tmilkovic51/stm32_usb_device/README.md

# STM32 USB device
A simple PCB consisting of an STM32F103C8T6 microcontroller acting as a USB device and 3 UART pin headers connected to MCU's UART pins.

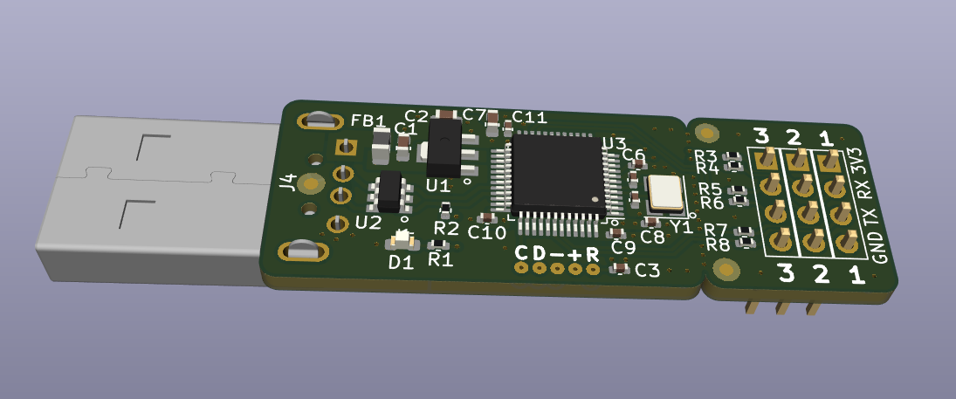
[picture p1: doc/img/stm32f1_usb_device_pcb.png]
STM32F1 USB device
