tmilkovic51/stm32_usb_device/stm32_usb_device.kicad_pcb

## KiCad design stm32_usb_device.kicad_pcb (2024-09-15)

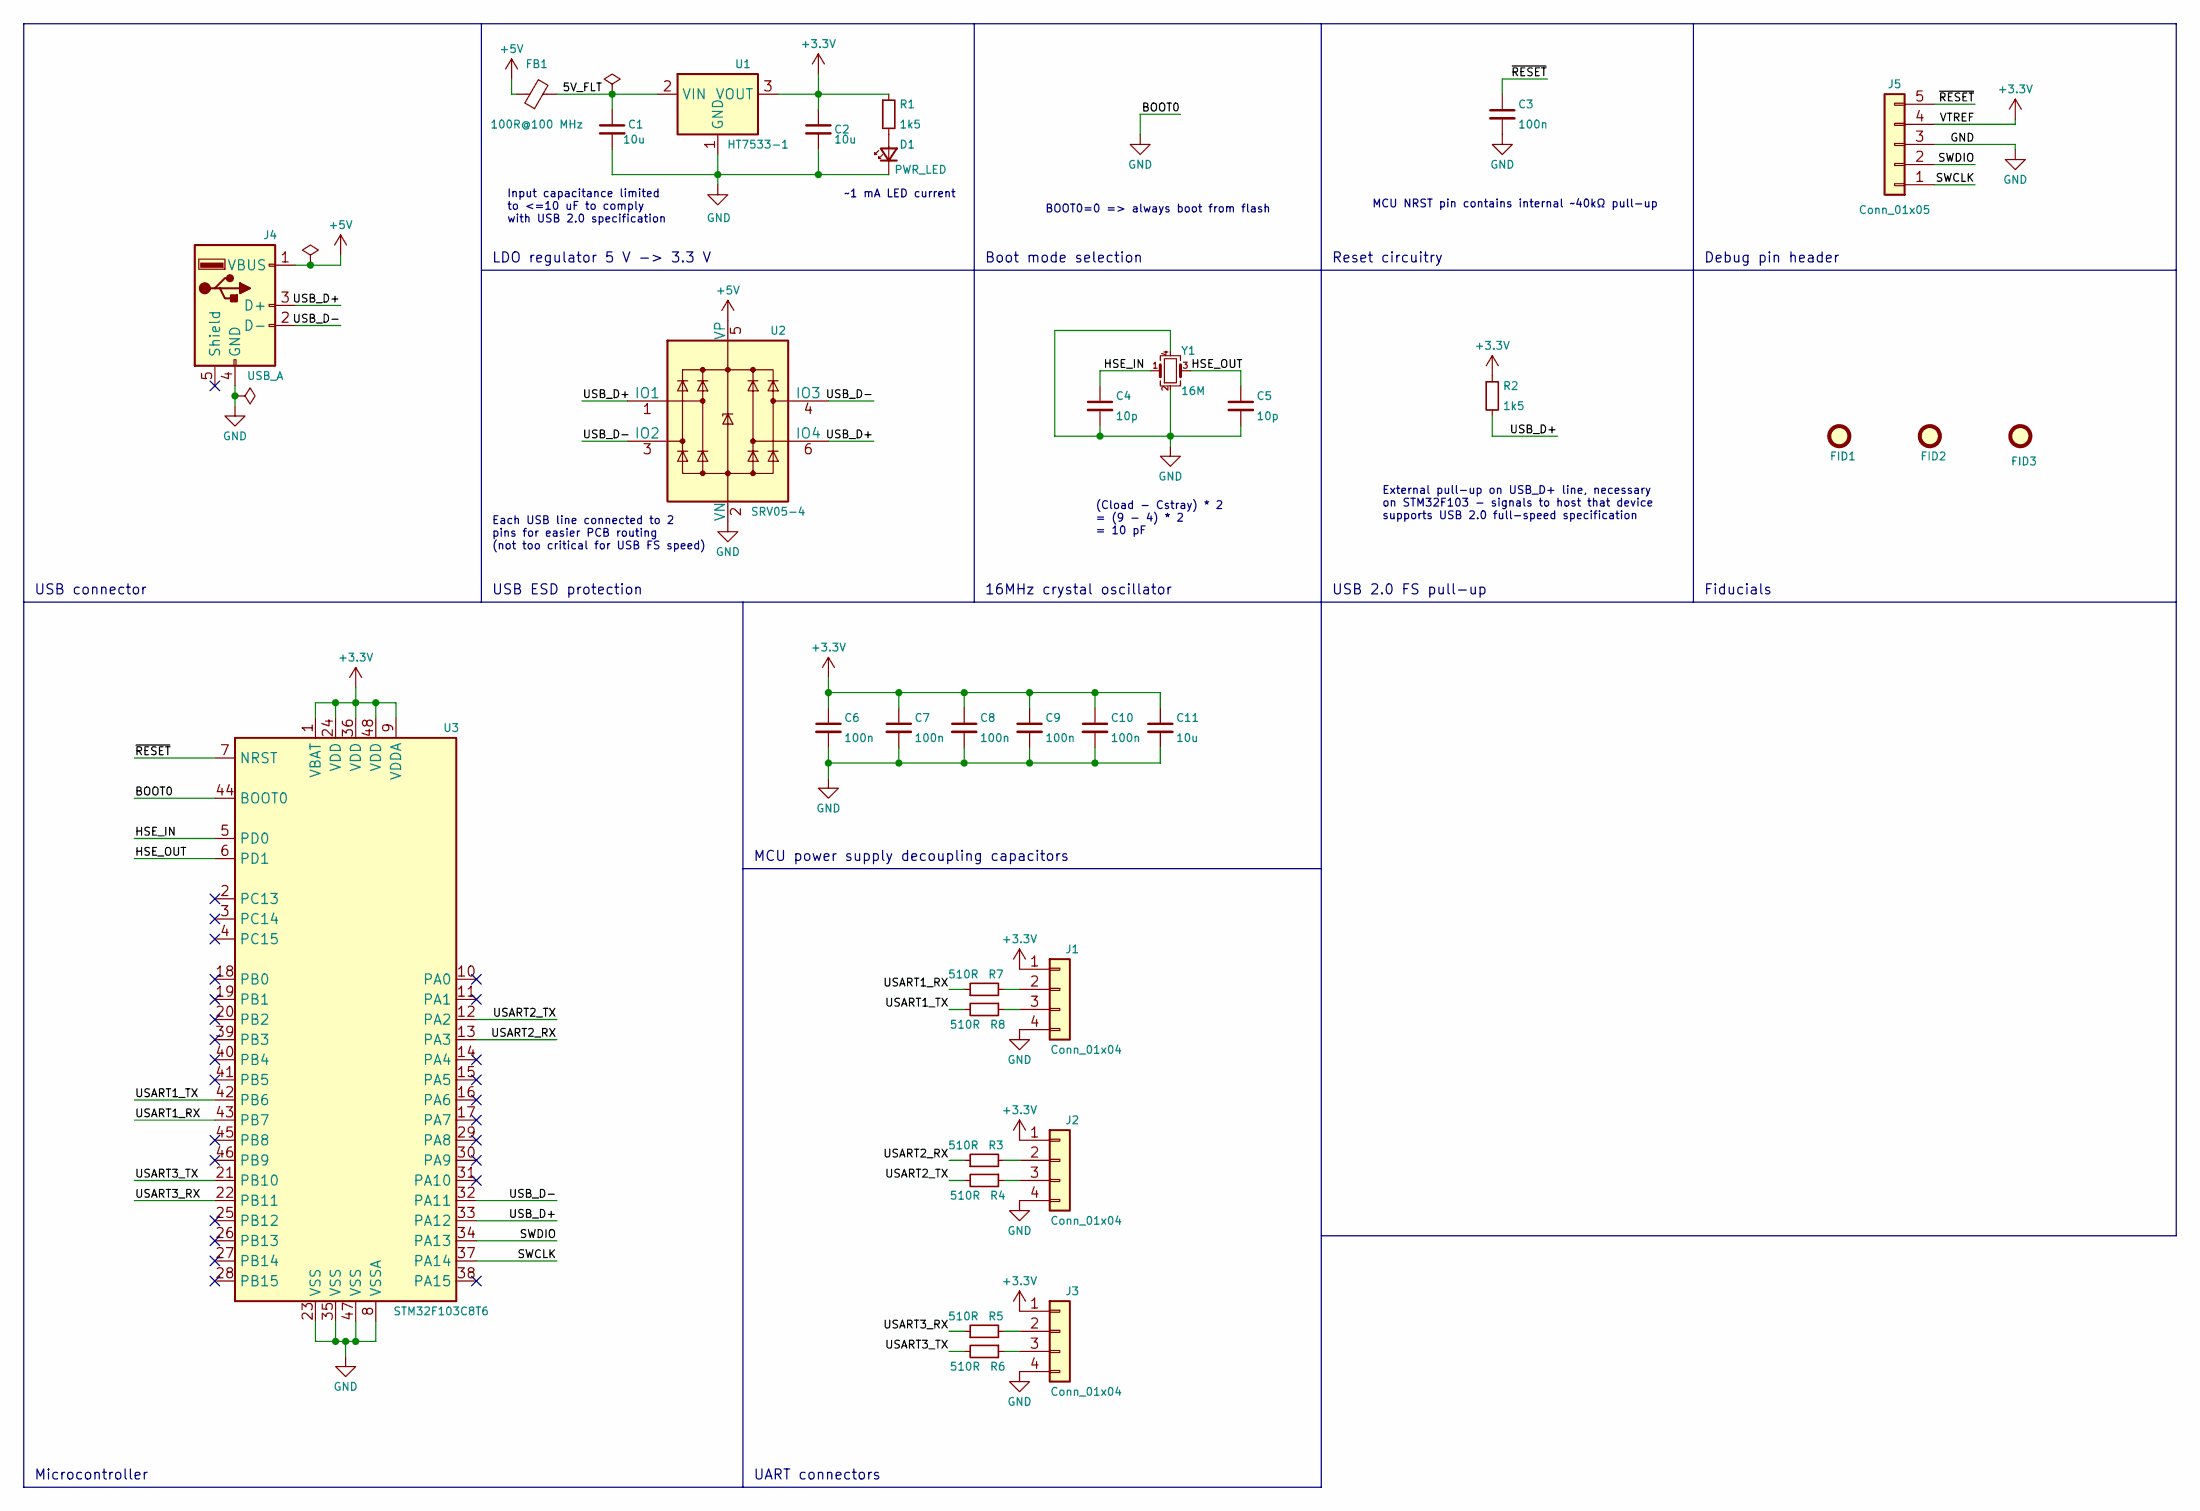
[picture p2: schematic stm32_usb_device.kicad_sch, STM32 USB to triple UART adapter]

Parts:
C1, C2, C11: 10u; C_0603_1608Metric; LCSC C96446
C3, C6, C7, C8, C9, C10: 100n; C_0402_1005Metric; LCSC C307331
C4, C5: 10p; C_0402_1005Metric; LCSC C32949
D1: PWR_LED; LED_0603_1608Metric; LCSC C2286
FB1: 100R@100 MHz; L_0805_2012Metric
FID1, FID2, FID3: Fiducial; Fiducial_1mm_Mask2mm
J1, J2, J3: Conn_01x04; PinHeader_1x04_P2.54mm_Vertical
J4: USB_A; USB_A_4pin
J5: Conn_01x05; PinHeader_1x05_P1.27mm_Vertical_SMD_Pin1Left
R1, R2: 1k5; R_0402_1005Metric; LCSC C25867
R3, R4, R5, R6, R7, R8: 510R; R_0402_1005Metric; LCSC C25123
U1: HT7533-1; SOT-89-3; LCSC C14289
U2: SRV05-4; SOT-23-6; LCSC C7420376
U3: STM32F103C8T6; LQFP-48_7x7mm_P0.5mm; LCSC C8734
Y1: 16M; Crystal_SMD_3225-4Pin_3.2x2.5mm; LCSC C13738

Connections:
+3.3V: C2.1, C6.1, C7.1, C8.1, C9.1, C10.1, C11.1, J1.1, J2.1, J3.1, J5.4, R1.1, R2.1, U1.3 (VOUT), U3.1 (VBAT), U3.9 (VDDA), U3.24 (VDD), U3.36 (VDD), U3.48 (VDD)
+5V: FB1.1, J4.1 (VBUS), U2.5 (VP)
/5V_FLT: C1.1, FB1.2, U1.2 (VIN)
/HSE_IN: C4.1, U3.5 (PD0), Y1.1
/HSE_OUT: C5.1, U3.6 (PD1), Y1.3
/SWCLK: J5.1, U3.37 (PA14)
/SWDIO: J5.2, U3.34 (PA13)
/USART1_RX: R7.1, U3.43 (PB7)
/USART1_TX: R8.2, U3.42 (PB6)
/USART2_RX: R3.1, U3.13 (PA3)
/USART2_TX: R4.2, U3.12 (PA2)
/USART3_RX: R5.1, U3.22 (PB11)
/USART3_TX: R6.2, U3.21 (PB10)
/USB_D+: J4.3 (D+), R2.2, U2.1 (IO1), U2.6 (IO4), U3.33 (PA12)
/USB_D-: J4.2 (D-), U2.3 (IO2), U2.4 (IO3), U3.32 (PA11)
/~RESET: C3.1, J5.5, U3.7 (NRST)
GND: C1.2, C2.2, C3.2, C4.2, C5.2, C6.2, C7.2, C8.2, C9.2, C10.2, C11.2, D1.1 (K), J1.4, J2.4, J3.4, J4.4 (GND), J5.3, U1.1 (GND), U2.2 (VN), U3.8 (VSSA), U3.23 (VSS), U3.35 (VSS), U3.44 (BOOT0), U3.47 (VSS), Y1.2, Y1.4
unnamed: D1.2 (A), R1.2
unnamed: J1.2, R7.2
unnamed: J1.3, R8.1
unnamed: J2.2, R3.2
unnamed: J2.3, R4.1
unnamed: J3.2, R5.2
unnamed: J3.3, R6.1

Notes on the sheet:
External pull-up on USB_D+ line, necessary on STM32F103 - signals to host that device supports USB 2.0 full-speed specification
LDO regulator 5 V -> 3.3 V
USB ESD protection
Each USB line connected to 2 pins for easier PCB routing (not too critical for USB FS speed)
Debug pin header
USB connector
BOOT0=0 => always boot from flash
Reset circuitry
Boot mode selection
~1 mA LED current
USB 2.0 FS pull-up
Microcontroller
Fiducials
(Cload - Cstray) * 2 = (9 - 4) * 2 = 10 pF
MCU power supply decoupling capacitors
16MHz crystal oscillator
UART connectors
Input capacitance limited to <=10 uF to comply with USB 2.0 specification
MCU NRST pin contains internal ~40kΩ pull-up

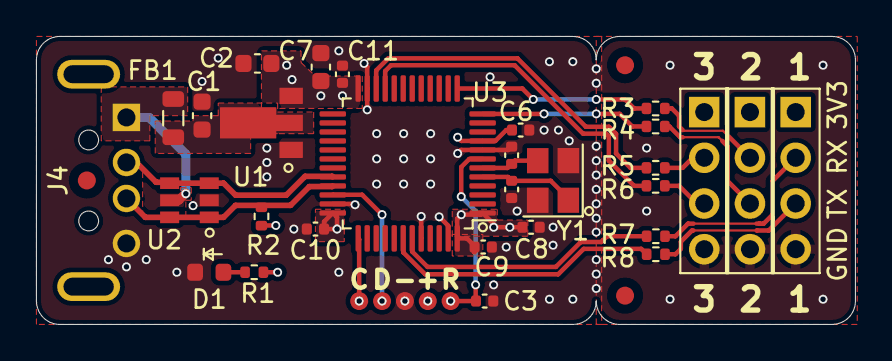
[picture p3: board stm32_usb_device.kicad_pcb from above]

Board: 4 copper layers, 45.5 x 16.0 mm, 33 parts (0 on the bottom side), 24 nets.
