tmilkovic51/stm32_usb_device/(commit log)

2024-01-02 Initialize KiCAD project
    [stm32_usb_device.kicad_pcb, stm32_usb_device.sch]
2024-01-02 Add USB connector, protection diodes and MCU
    [stm32_usb_device.sch]
2024-01-02 schematic: Add power supply, decoupling caps, pin headers
    [stm32_usb_device.kicad_pcb, stm32_usb_device.sch]
2024-01-11 Add USB connector and UART isolators
    Make initial PCB layout and routing
    [stm32_usb_device.kicad_pcb, stm32_usb_device.sch]
2024-01-17 Finish PCB routing
    [stm32_usb_device.kicad_pcb, stm32_usb_device.sch]
2024-01-18 Remove unused net labels
    [stm32_usb_device.kicad_pcb, stm32_usb_device.sch]
2024-09-15 Update project to KiCad v6
    [stm32_usb_device.kicad_pcb, stm32_usb_device.kicad_sch, stm32_usb_device.sch]
2024-09-15 Add image of finished PCBA to doc folder
